hanshuebner/pi-serpar/README.md

# pi-serpar

This is an extension of the
[pi-parport](https://github.com/worlickwerx/pi-parport) HAT by
WorlickWerx, adding a RS232 serial port to the original design.

WORK IN PROGRESS, DO NOT PRODUCE PCBs FROM THIS YET
