hanshuebner/pi-serpar/hardware/pi-serpar.kicad_pcb

## KiCad design hardware/pi-serpar.kicad_pcb (2024-04-10)

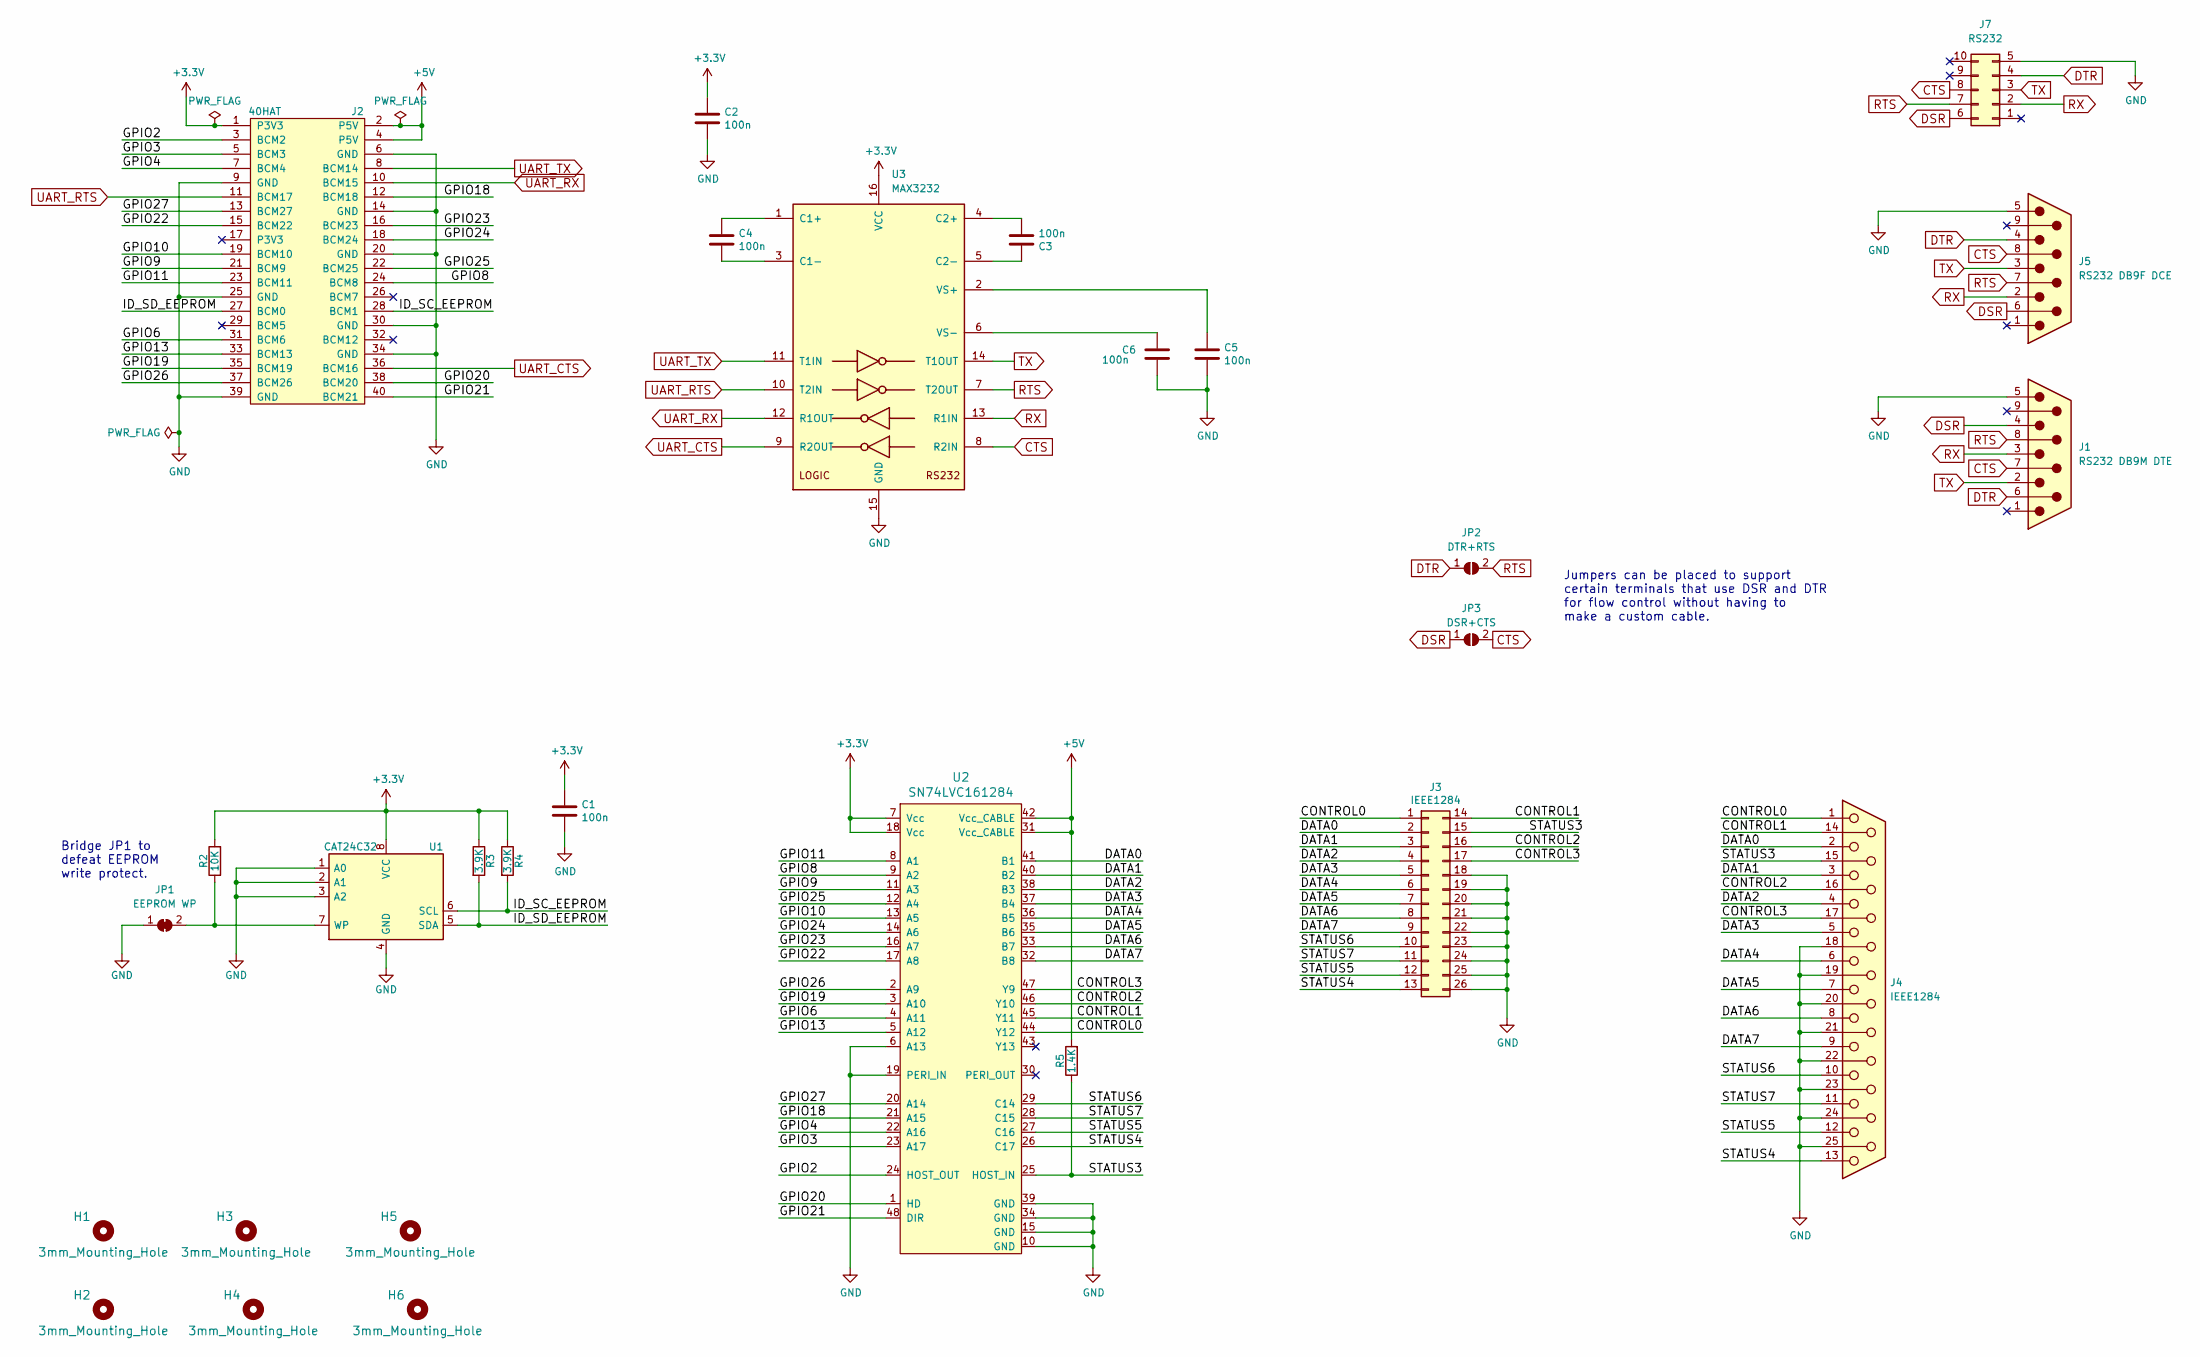
[picture p1: schematic pi-serpar.kicad_sch, Raspberry Pi IEEE 1284 & Serial Port HAT]

Parts:
C1, C2, C3, C4, C5, C6: 100n; C_0603_1608Metric_Pad1.08x0.95mm_HandSolder; MPN C0805C104Z5VACTU; Digi-Key_PN 399-1177-1-ND
H1, H2, H3, H4, H5, H6: 3mm_Mounting_Hole; NPTH_3mm_ID
J1: RS232 DB9M DTE; DSUB-9_Male_Horizontal_P2.77x2.84mm_EdgePinOffset7.70mm_Hou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
J2: 40HAT; PinSocket_2x20_P2.54mm_Vertical; MPN PPPC202LFBN-RC; Digi-Key_PN S7123-ND
J3: IEEE1284; PinHeader_2x13_P2.54mm_Vertical; MPN 68021-226HLF; Digi-Key_PN 609-3349-ND
J4: IEEE1284; DSUB-25_Female_Horizontal_P2.77x2.84mm_EdgePinOffset7.70mm_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
J5: RS232 DB9F DCE; DSUB-9_Female_Horizontal_P2.77x2.84mm_EdgePinOffset7.70mm_H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
J7: RS232; PinHeader_2x05_P2.54mm_Vertical
JP1: EEPROM WP; SolderJumper-2_P1.3mm_Bridged_Pad1.0x1.5mm
JP2: DTR+RTS; SolderJumper-2_P1.3mm_Open_RoundedPad1.0x1.5mm
JP3: DSR+CTS; SolderJumper-2_P1.3mm_Open_RoundedPad1.0x1.5mm
R2: 10K; R_0603_1608Metric_Pad0.98x0.95mm_HandSolder; MPN ERJ-6ENF1002V; Digi-Key_PN P10.0KCCT-ND
R3, R4: 3.9K; R_0603_1608Metric_Pad0.98x0.95mm_HandSolder; MPN ERJ-6ENF3901V; Digi-Key_PN P3.90KCCT-ND
R5: 1.4K; R_0603_1608Metric_Pad0.98x0.95mm_HandSolder; MPN ERJ-6ENF1401V; Digi-Key_PN P1.40KCCT-ND
U1: CAT24C32; SOIC-8_3.9x4.9mm_P1.27mm; MPN CAT24C32WI-GT3; Digi-Key_PN CAT24C32WI-GT3CT-ND
U2: SN74LVC161284; TSSOP-48_6.1x12.5mm_P0.5mm; MPN SN74LVC161284DL; Digi-Key_PN 296-8467-5-ND
U3: MAX3232; SO-16_3.9x9.9mm_P1.27mm

Connections:
+3V3: C1.1, C2.1, J2.1 (P3V3), R2.2, R3.1, R4.1, U1.8 (VCC), U2.7 (Vcc), U2.18 (Vcc), U3.16 (VCC)
+5V: J2.2 (P5V), J2.4 (P5V), R5.2, U2.31 (Vcc_CABLE), U2.42 (Vcc_CABLE)
/CONTROL0: J3.1, J4.1, U2.44 (Y12)
/CONTROL1: J3.14, J4.14, U2.45 (Y11)
/CONTROL2: J3.16, J4.16, U2.46 (Y10)
/CONTROL3: J3.17, J4.17, U2.47 (Y9)
/DATA0: J3.2, J4.2, U2.41 (B1)
/DATA1: J3.3, J4.3, U2.40 (B2)
/DATA2: J3.4, J4.4, U2.38 (B3)
/DATA3: J3.5, J4.5, U2.37 (B4)
/DATA4: J3.6, J4.6, U2.36 (B5)
/DATA5: J3.7, J4.7, U2.35 (B6)
/DATA6: J3.8, J4.8, U2.33 (B7)
/DATA7: J3.9, J4.9, U2.32 (B8)
/GPIO2: J2.3 (BCM2), U2.24 (HOST_OUT)
/GPIO3: J2.5 (BCM3), U2.23 (A17)
/GPIO4: J2.7 (BCM4), U2.22 (A16)
/GPIO6: J2.31 (BCM6), U2.4 (A11)
/GPIO8: J2.24 (BCM8), U2.9 (A2)
/GPIO9: J2.21 (BCM9), U2.11 (A3)
/GPIO10: J2.19 (BCM10), U2.13 (A5)
/GPIO11: J2.23 (BCM11), U2.8 (A1)
/GPIO13: J2.33 (BCM13), U2.5 (A12)
/GPIO18: J2.12 (BCM18), U2.21 (A15)
/GPIO19: J2.35 (BCM19), U2.3 (A10)
/GPIO20: J2.38 (BCM20), U2.1 (HD)
/GPIO21: J2.40 (BCM21), U2.48 (DIR)
/GPIO22: J2.15 (BCM22), U2.17 (A8)
/GPIO23: J2.16 (BCM23), U2.16 (A7)
/GPIO24: J2.18 (BCM24), U2.14 (A6)
/GPIO25: J2.22 (BCM25), U2.12 (A4)
/GPIO26: J2.37 (BCM26), U2.2 (A9)
/GPIO27: J2.13 (BCM27), U2.20 (A14)
/ID_SC_EEPROM: J2.28 (BCM1), R4.2, U1.6 (SCL)
/ID_SD_EEPROM: J2.27 (BCM0), R3.2, U1.5 (SDA)
/STATUS3: J3.15, J4.15, R5.1, U2.25 (HOST_IN)
/STATUS4: J3.13, J4.13, U2.26 (C17)
/STATUS5: J3.12, J4.12, U2.27 (C16)
/STATUS6: J3.10, J4.10, U2.29 (C14)
/STATUS7: J3.11, J4.11, U2.28 (C15)
CTS: J1.7, J5.8, J7.8, JP3.2 (B), U3.8 (R2IN)
DSR: J1.4, J5.6, J7.6, JP3.1 (A)
DTR: J1.6, J5.4, J7.4, JP2.1 (A)
GND: C1.2, C2.2, C5.2, C6.2, J1.5, J2.6 (GND), J2.9 (GND), J2.14 (GND), J2.20 (GND), J2.25 (GND), J2.30 (GND), J2.34 (GND), J2.39 (GND), J3.18, J3.19, J3.20, J3.21, J3.22, J3.23, J3.24, J3.25, J3.26, J4.18, J4.19, J4.20, J4.21, J4.22, J4.23, J4.24, J4.25, J5.5, J7.5, JP1.1 (A), U1.1 (A0), U1.2 (A1), U1.3 (A2), U1.4 (GND), U2.6 (A13), U2.10 (GND), U2.15 (GND), U2.19 (PERI_IN), U2.34 (GND), U2.39 (GND), U3.15 (GND)
unnamed: JP1.2 (B), R2.1, U1.7 (WP)
unnamed: C4.1, U3.1 (C1+)
unnamed: C4.2, U3.3 (C1-)
unnamed: C3.2, U3.4 (C2+)
unnamed: C3.1, U3.5 (C2-)
unnamed: C5.1, U3.2 (VS+)
unnamed: C6.1, U3.6 (VS-)
RTS: J1.8, J5.7, J7.7, JP2.2 (B), U3.7 (T2OUT)
RX: J1.3, J5.2, J7.2, U3.13 (R1IN)
TX: J1.2, J5.3, J7.3, U3.14 (T1OUT)
UART_CTS: J2.36 (BCM16), U3.9 (R2OUT)
UART_RTS: J2.11 (BCM17), U3.10 (T2IN)
UART_RX: J2.10 (BCM15), U3.12 (R1OUT)
UART_TX: J2.8 (BCM14), U3.11 (T1IN)

Notes on the sheet:
Bridge JP1 to defeat EEPROM write protect.
Jumpers can be placed to support certain terminals that use DSR and DTR for flow control without having to make a custom cable.

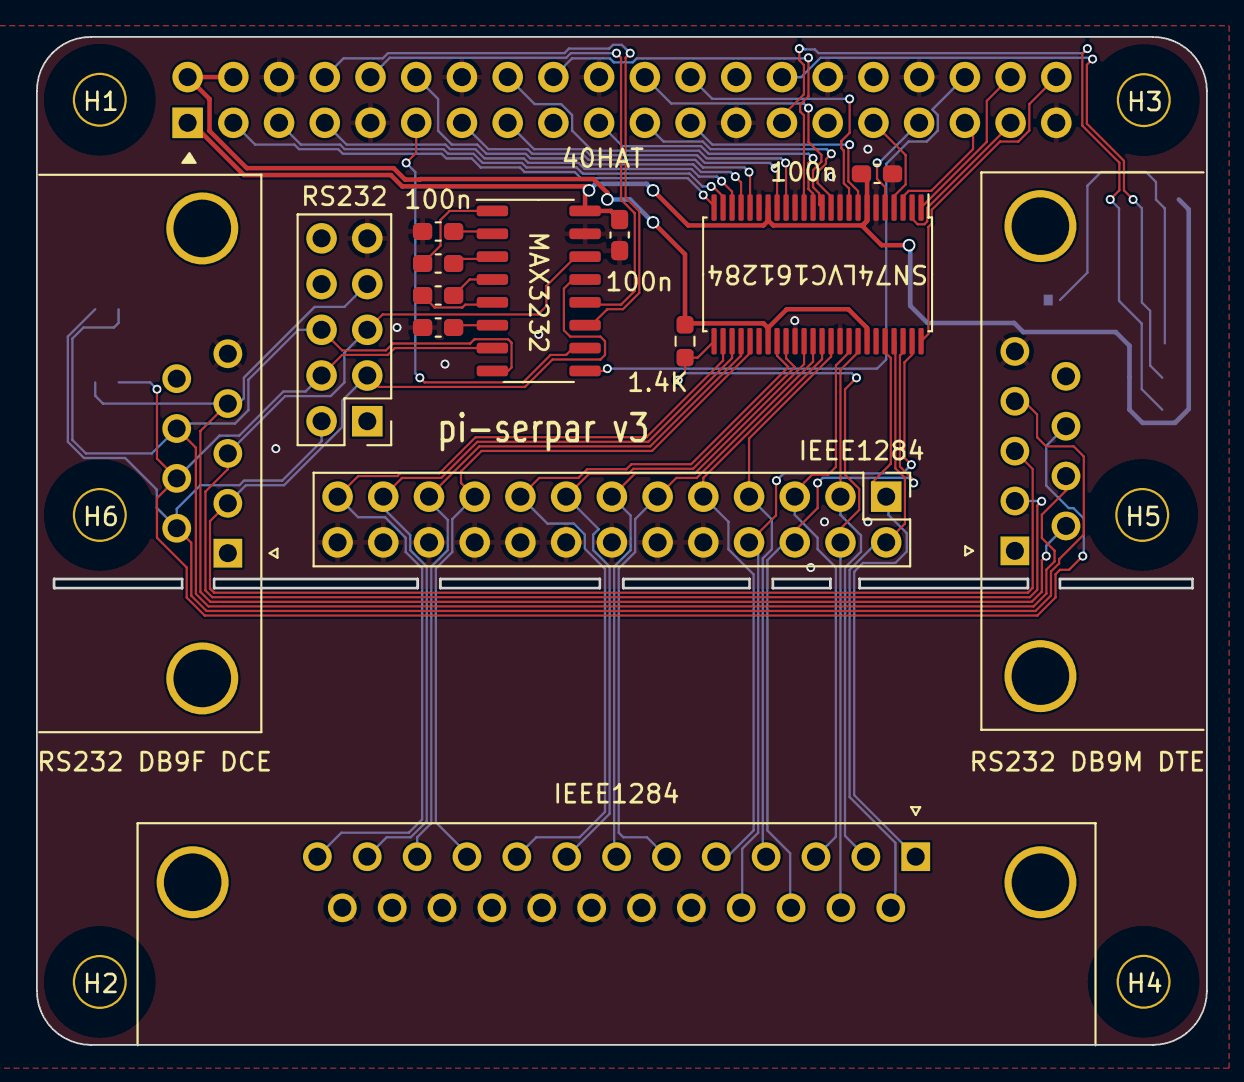
[picture p2: board pi-serpar.kicad_pcb from above]

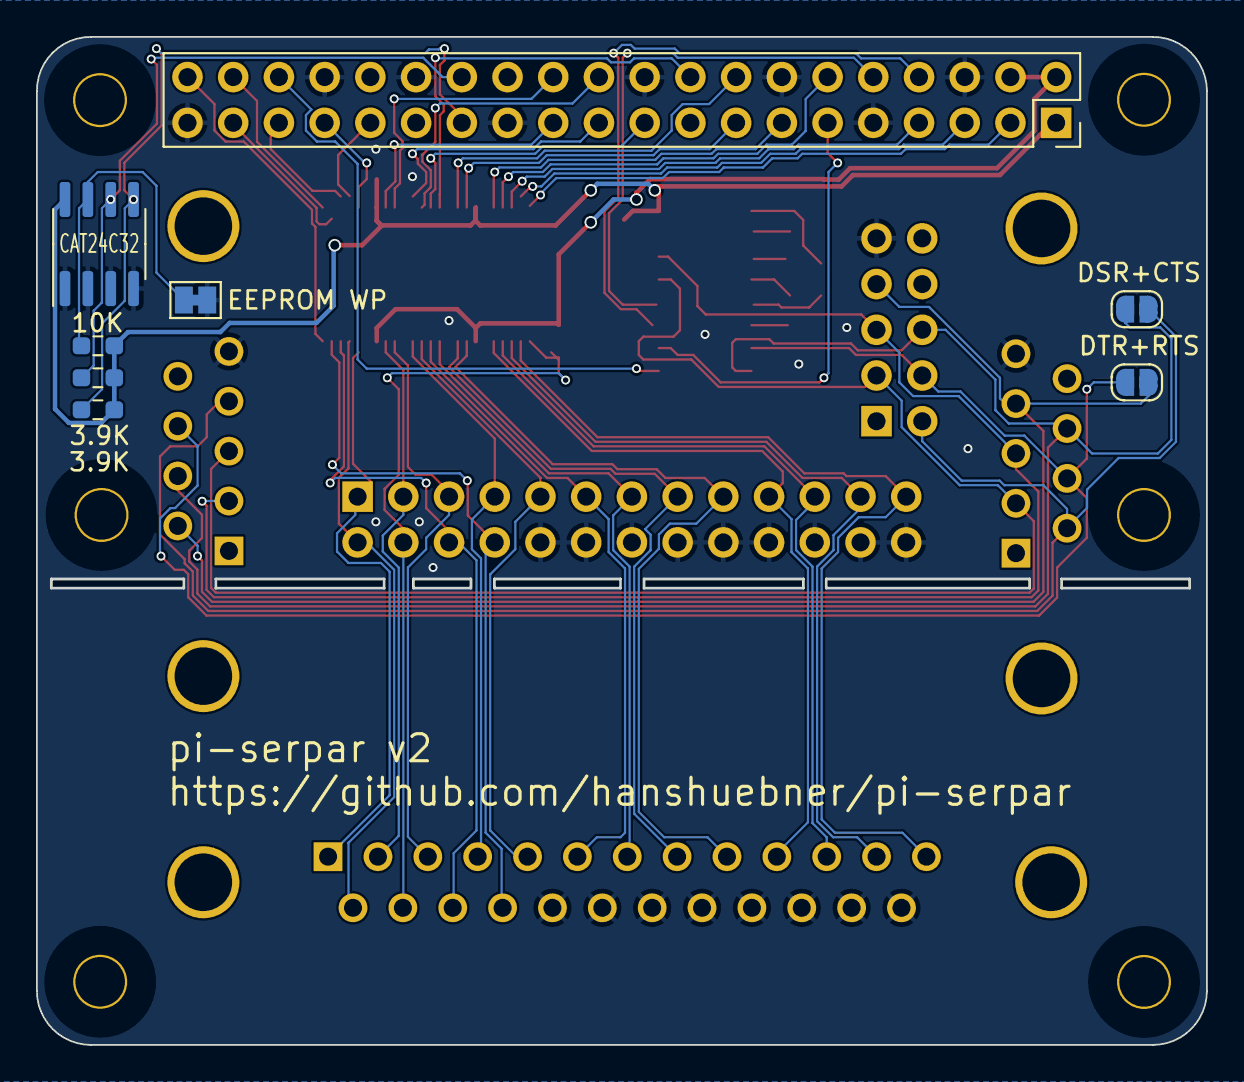
[picture p3: board pi-serpar.kicad_pcb from below]

Board: 2 copper layers, 65.0 x 56.0 mm, 28 parts (8 on the bottom side), 58 nets.
