hanshuebner/pi-serpar/(commit log)

2024-03-12 save work
    [pi-parport.kicad_pcb, pi-parport.kicad_sch]
2024-03-12 code golf
    [parport.brd, parport.sch, pi-parport.kicad_pcb, pi-parport.kicad_sch, pi-parport.sch]
2024-03-12 file renames
    [pi-serpar.kicad_pcb, pi-serpar.kicad_sch]
2024-03-12 v1 ordered at jlcpcb
    [pi-serpar.kicad_pcb, pi-serpar.kicad_sch]
2024-03-20 IEEE1284 in TSSOP-48 package
    [pi-serpar.kicad_pcb, pi-serpar.kicad_sch]
2024-04-08 fix idc footprints, add db9h
    [pi-serpar.kicad_pcb, pi-serpar.kicad_sch]
2024-04-10 v3 with dual db9 footprints
    [pi-serpar.kicad_pcb, pi-serpar.kicad_sch]
